zhwx2006/SmartWatch/wathc.jpg

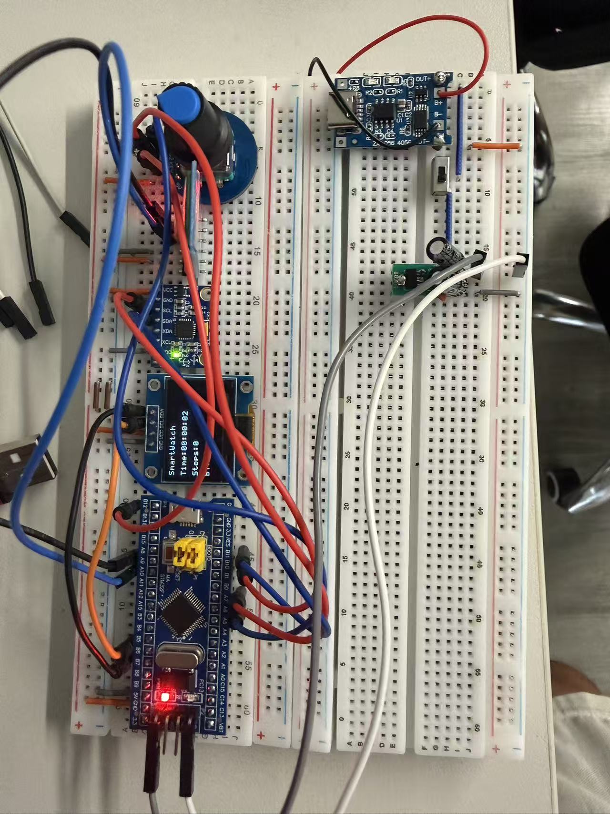
wathc.jpg
