zhwx2006/SmartWatch/功能简单报告.md

# 基于STM32F103C8T6的智能手表设计 — 功能验收报告

> **课程名称**：嵌入式系统课程设计  
> **项目题目**：基于STM32F103C8T6的智能手表设计  
> **团队成员**：林子杰（3124009649）、张文轩（3124006257）、谢徐州  
> **指导老师**：周贤中  
> **完成日期**：2026年7月

---

## 1. 项目概述

本项目以 **STM32F103C8T6** 最小系统板为核心控制器，设计并实现了一款可穿戴智能手表原型。系统集成了 0.96 寸 OLED 显示屏、MPU6050 六轴姿态传感器、HC-05 蓝牙串口模块、EC11 旋转编码器，以及基于 TP4056 + HT7333 的锂电池充电稳压供电方案。软件采用 **FreeRTOS** 实时操作系统实现多任务并发调度，涵盖显示刷新、传感器采集、蓝牙通信、菜单交互等功能。

---

## 2. 硬件组成

| 序号 | 模块 | 型号/规格 | 通信接口 | 用途 |
|:---|:---|:---|:---|:---|
| 1 | 主控板 | STM32F103C8T6 | — | 系统核心控制器 |
| 2 | 显示屏 | 0.96 寸 SSD1306 | I2C1 (PB6/PB7) | 本地信息展示 |
| 3 | 姿态传感器 | MPU6050 / GY-521 | I2C1 (PB6/PB7) | 加速度、角速度、温度采集 |
| 4 | 蓝牙模块 | HC-05 主从一体 | USART1 (PA9/PA10) | 与手机蓝牙串口助手通信 |
| 5 | 旋转编码器 | EC11 带按键 | TIM3 (PA6/PA7) + EXTI (PB10) | 菜单切换与确认交互 |
| 6 | 充电模块 | TP4056 Type-C 保护板 | — | 锂电池充电与保护 |
| 7 | 稳压芯片 | HT7333-3.3V | — | 3.3V LDO 稳压输出 |
| 8 | 锂电池 | 3.7V 聚合物电池 | — | 便携供电 |
| 9 | 下载器 | ST-Link V2 | SWD (PA13/PA14) | 程序下载与调试 |

> **供电链路**：3.7V 锂电池 → TP4056 → HT7333-3.3V → 3.3V 电源轨  
> **注意**：TP4056 OUT+ 输出为电池电压（3.0V–4.2V），**不可直接**接入 STM32 3V3 引脚，必须经过 HT7333 稳压至 3.3V 后方可供电。

---

## 3. 关键引脚分配表

| 功能 | STM32 引脚 | 外设引脚 | 说明 |
|:---|:---|:---|:---|
| I2C1 SCL | PB6 | OLED SCL / MPU6050 SCL | 400kHz Fast Mode，开漏输出 |
| I2C1 SDA | PB7 | OLED SDA / MPU6050 SDA | 与 SCL 共用 I2C 总线 |
| USART1 TX | PA9 | HC-05 RXD | 经 1kΩ 电阻串联保护 |
| USART1 RX | PA10 | HC-05 TXD | 波特率 115200，8N1 |
| TIM3 CH1 | PA6 | EC11 A 相 / CLK | 编码器正交解码输入 |
| TIM3 CH2 | PA7 | EC11 B 相 / DT | 编码器正交解码输入 |
| EXTI10 | PB10 | EC11 SW / KEY | 下降沿触发，上拉输入 |
| ADC1_IN0 | PA0 | 电池分压检测（预留） | 电池电量估算（未完全实现） |
| SWDIO | PA13 | ST-Link SWDIO | 调试接口 |
| SWCLK | PA14 | ST-Link SWCLK | 调试接口 |

> **I2C 地址**：OLED = 0x3C（HAL 中写为 0x78），MPU6050 = 0x68（AD0 接 GND）。两设备地址不同，可安全共线。

---

## 4. 软件功能模块

### 4.1 系统架构

软件采用 **模块化分层 + FreeRTOS 多任务** 架构，核心源码文件如下：

| 文件名 | 功能说明 |
|:---|:---|
| `ssd1306.c/h` | OLED 屏幕底层驱动（初始化、清屏、字符/字符串显示） |
| `mpu6050.c/h` | 六轴传感器读写、姿态解算（Pitch / Roll）、温度读取 |
| `bluetooth.c/h` | HC-05 串口收发协议，传感器数据帧打包与发送 |
| `freertos.c / FreeRTOSConfig.h` | RTOS 任务创建、调度配置、互斥量与信号量管理 |
| `menu.c` | 多级菜单逻辑、编码器事件处理、界面渲染 |

### 4.2 FreeRTOS 任务划分

| 任务名称 | 功能 | 周期/触发方式 | 状态 |
|:---|:---|:---|:---|
| `taskTimeKeep` | 系统计时、时间变量更新 | 1 s | 运行正常 |
| `taskSensor` | MPU6050 采样、计步数据计算 | 50 ms | 运行正常 |
| `taskDisplay` | OLED 页面渲染、画面刷新 | 信号量触发 / 超时刷新 | 运行正常 |
| `taskMenu` | EC11 编码器扫描、菜单事件处理 | 20 ms | 运行正常 |
| `taskBluetooth` | 蓝牙数据打包发送、指令解析 | 500 ms | 运行正常 |

> **资源保护**：OLED 与 MPU6050 共用 I2C1 总线，通过 **mutexI2C 互斥量** 实现安全访问，避免多任务并发抢占总线导致死锁。

---

## 5. 分阶段功能验收结果

项目按 **渐进式开发** 分 5 个阶段依次验收，逐模块验证驱动与业务逻辑完整性。

### 阶段 1：OLED 屏幕显示功能

| 验收项 | 预期标准 | 实际结果 | 结论 |
|:---|:---|:---|:---|
| 上电初始化 | 屏幕正常点亮，无花屏闪烁 | 正常点亮显示 | ✅ 通过 |
| 字符串打印 | 可输出启动提示、Hello World | 文字清晰稳定 | ✅ 通过 |
| I2C 地址扫描 | 总线可正常应答 0x3C | 扫描识别 0x3C | ✅ 通过 |
| 动态画面刷新 | 持续刷新界面无卡顿 | 刷新流畅无撕裂 | ✅ 通过 |

### 阶段 2：MPU6050 姿态传感器采集

| 验收项 | 预期标准 | 实际结果 | 结论 |
|:---|:---|:---|:---|
| 芯片 ID 校验 | WHO_AM_I 返回 0x68 | 返回 0x68 | ✅ 通过 |
| 原始数据读取 | 三轴加速度、角速度、温度可读 | 数据正常更新 | ✅ 通过 |
| 姿态解算 | Pitch / Roll 随倾斜变化 | 平放接近 0°，倾斜随之变化 | ✅ 通过 |

### 阶段 3：HC-05 蓝牙通信功能

| 验收项 | 预期标准 | 实际结果 | 结论 |
|:---|:---|:---|:---|
| 手机连接 | 可搜索、可配对、可连接 | 蓝牙串口助手正常连接 | ✅ 通过 |
| 数据透传 | 持续收到传感器数据帧 | 长时间连接数据不中断 | ✅ 通过 |
| 数据格式 | AX, AY, AZ, Pitch, Roll, Temp | 格式正确，无乱码 | ✅ 通过 |

### 阶段 4：FreeRTOS 多任务调度

| 验收项 | 预期标准 | 实际结果 | 结论 |
|:---|:---|:---|:---|
| 任务创建 | 5 个任务均正常启动 | 全部创建成功 | ✅ 通过 |
| 并发运行 | 长时间运行无死锁、无阻塞 | 运行稳定 | ✅ 通过 |
| 资源互斥 | I2C 总线共享无冲突 | mutex 保护正常 | ✅ 通过 |

### 阶段 5：计步算法与多级菜单框架

| 验收项 | 预期标准 | 实际结果 | 结论 |
|:---|:---|:---|:---|
| 基础步数检测 | 可识别正常行走动作 | 10 步识别 8 步 | ⚠️ 基本通过 |
| 菜单列表渲染 | 可切换进入功能菜单界面 | 菜单文字、光标正常显示 | ✅ 通过 |
| 编码器旋转交互 | 旋转旋钮移动光标、切换页面 | 响应灵敏无卡顿 | ✅ 通过 |
| 编码器按键逻辑 | 短按确认、长按返回上一级 | 按键逻辑基本正常 | ✅ 通过 |
| 深层子菜单 | 时间设置、蓝牙配置完整交互 | 仅搭建页面框架 | ❌ 待完善 |

---

## 6. 整机综合联调测试

| 序号 | 测试项目 | 判定标准 | 结果 |
|:---|:---|:---|:---|
| 1 | 电源供电稳定性 | HT7333 VOUT = 3.25V–3.35V | ✅ 通过 |
| 2 | I2C 总线设备扫描 | 识别 0x3C (OLED) + 0x68 (MPU6050) | ✅ 通过 |
| 3 | OLED 整机显示 | 多任务切换画面清晰，无花屏闪烁 | ✅ 通过 |
| 4 | MPU6050 整机采集 | 姿态变化数据实时更新不卡顿 | ✅ 通过 |
| 5 | 蓝牙整机通信 | 长时间连接持续输出传感器数据帧 | ✅ 通过 |
| 6 | FreeRTOS 整机调度 | 长时间运行无死机、无界面卡死 | ✅ 通过 |
| 7 | 计步整机实测 | 人工行走 17 步，系统识别 19 步 | ⚠️ 基本可用，精度偏差 |
| 8 | 菜单整机交互 | 完整浏览、切换、返回一级菜单无故障 | ✅ 通过 |

---

## 7. 现存缺陷与优化方向

| 序号 | 问题描述 | 原因分析 | 优化建议 |
|:---|:---|:---|:---|
| 1 | 计步精度不足 | 动态阈值与滤波参数需调优 | 引入自适应阈值、加速度模值滑动窗口滤波 |
| 2 | 深层子菜单未完善 | 时间设置、蓝牙配置交互逻辑未开发 | 补充菜单状态机与参数编辑逻辑 |
| 3 | 无低功耗控制 | 未实现睡眠/待机模式 | 添加 FreeRTOS Tickless Idle、外设按需开关 |
| 4 | 断电时间丢失 | 未接入 RTC 备用电池或超级电容 | 增加 RTC 独立供电电路 |
| 5 | 电池电量显示缺失 | 仅预留 PA0 ADC 分压检测，未实现软件 | 完成 ADC 采样与电量百分比换算 |
| 6 | 面包板连接稳定性差 | 杜邦线接触不良、长期易松动 | 转为洞洞板焊接或设计 PCB |
| 7 | I2C 上拉电阻不足 | 手头仅 1kΩ 电阻，未备 4.7kΩ | 补充 4.7kΩ 上拉，提升总线稳定性 |
| 8 | HC-05 供电敏感 | 整机带载时 3.3V 纹波可能影响蓝牙 | 优化 LDO 输出电容或换用更大电流稳压方案 |

---

## 8. 项目验收结论

| 功能模块 | 验收结论 |
|:---|:---|
| OLED 屏幕显示驱动 | ✅ 通过 |
| MPU6050 姿态传感器采集 | ✅ 通过 |
| HC-05 蓝牙无线通信 | ✅ 通过 |
| FreeRTOS 多任务实时调度 | ✅ 通过 |
| EC11 编码器菜单人机交互 | ✅ 通过 |
| 计步算法与高级穿戴功能 | ⚠️ 基本通过，需迭代优化 |
| **软件整体综合验收** | **✅ 通过验收** |

本项目已完成课程设计要求的所有核心功能：OLED 显示、六轴传感器数据采集、蓝牙串口透传、FreeRTOS 多任务并发、编码器菜单交互、基础计步功能。各硬件驱动稳定可靠，多任务资源互斥访问逻辑正常，整机长时间运行无死机、无外设冲突。系统在计步精度、低功耗管理、多级菜单完整交互等方面存在优化空间，可作为后续二次迭代方向。

---

## 9. 物料与成本估算

| 序号 | 物料名称 | 型号/规格 | 数量 | 估算单价 |
|:---|:---|:---|:---:|---:|
| 1 | STM32 最小系统板 | STM32F103C8T6 | 1 | 15 元 |
| 2 | OLED 显示屏 | 0.96 寸 SSD1306 I2C | 1 | 12 元 |
| 3 | 姿态传感器 | MPU6050 / GY-521 | 1 | 5 元 |
| 4 | 蓝牙模块 | HC-05 | 1 | 10 元 |
| 5 | 旋转编码器 | EC11 带按键 | 1 | 2 元 |
| 6 | 充电模块 | TP4056 Type-C 保护板 | 1 | 3 元 |
| 7 | 稳压芯片 | HT7333-3.3V | 1 | 1 元 |
| 8 | 锂电池 | 3.7V 聚合物电池 | 1 | 15 元 |
| 9 | ST-Link 下载器 | ST-Link V2 | 1 | 8 元 |
| 10 | USB-TTL | CH340 / CP2102 | 1 | 8 元 |
| 11 | 面包板 | 5cm×7cm 或更大 | 1 | 5 元 |
| 12 | 杜邦线 | 公对母/母对母/公对公 | 若干 | 5 元 |
| 13 | 电阻 | 1kΩ、4.7kΩ 等 | 若干 | 2 元 |
| 14 | 电容 | 10µF、0.1µF | 若干 | 2 元 |
| | | **估算总成本** | | **约 90 元以内** |
