zhwx2006/SmartWatch/(commit log)

2026-06-29 初次上传智能手表项目全部文件
2026-07-08 上传最终版代码
